LucaCorradi89/MotorPR_PCB/MotorPR.brd

## EAGLE design MotorPR.brd (2021-03-21)

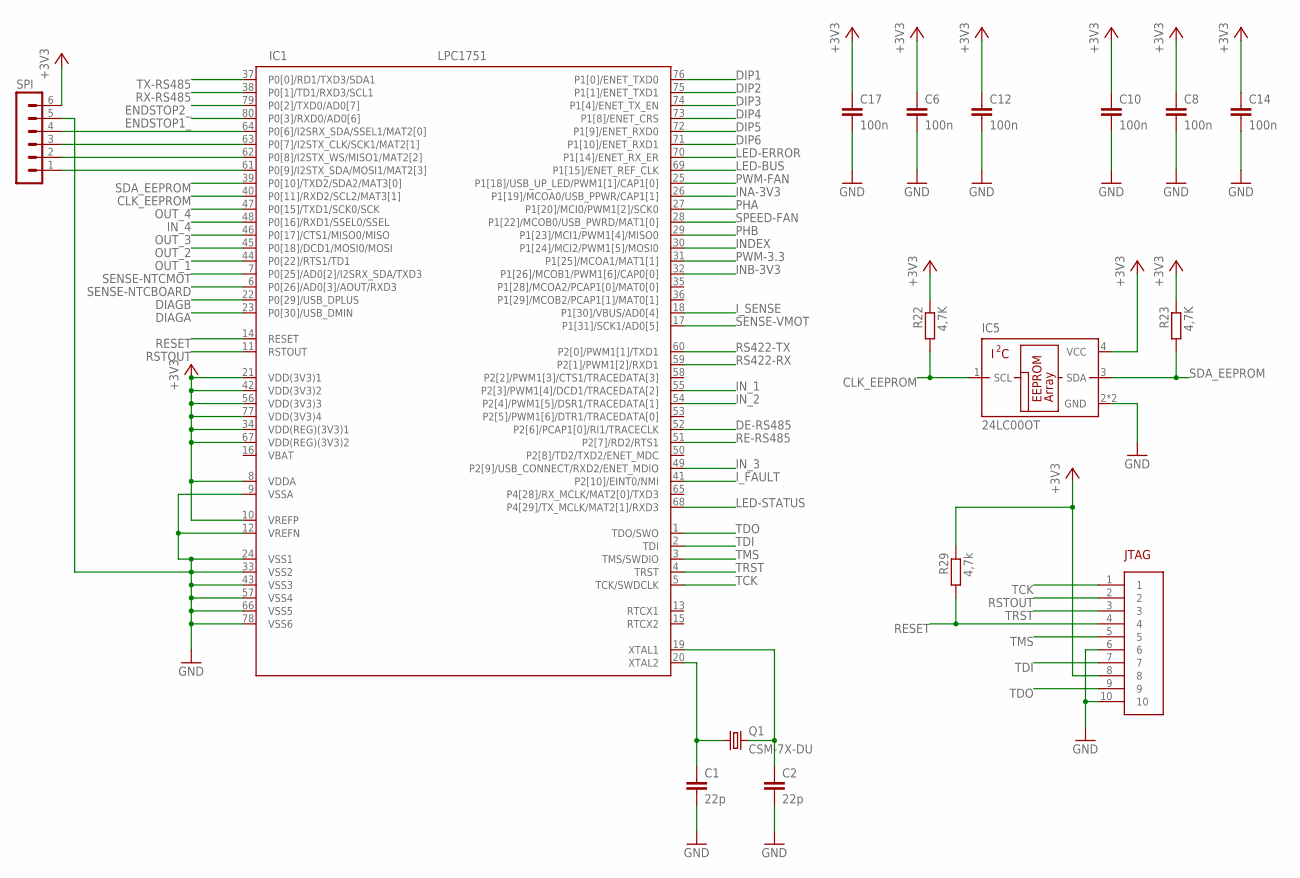
[picture p1: schematic MotorPR.sch, sheet 1, LOGICA]

Parts:
C1, C2: 22p; C0805
C6, C8, C10, C12, C14, C17: 100n; C0805
IC1: LPC1751; LQFP80-12X12
IC5: 24LC00OT; SOT23-5L
JTAG: MOLEX-52808-1070
Q1: CSM-7X-DU
R22, R23: 4,7K; R0805W
R29: 4,7k; R0805W
SPI: MA06-1

Connections:
+3V3: C6.1, C8.1, C10.1, C12.1, C14.1, C17.1, IC1.8 (VDDA), IC1.10 (VREFP), IC1.21 (VDD(3V3)1), IC1.34 (VDD(REG)(3V3)1), IC1.42 (VDD(3V3)2), IC1.56 (VDD(3V3)3), IC1.67 (VDD(REG)(3V3)2), IC1.77 (VDD(3V3)4), IC5.4 (VCC), JTAG.8, R22.1, R23.1, R29.1, SPI.6; also elsewhere on the board
CLK_EEPROM: IC1.40 (P0[11]/RXD2/SCL2/MAT3[1]), IC5.1 (SCL), R22.2
DE-RS485: IC1.52 (P2[6]/PCAP1[0]/RI1/TRACECLK); also elsewhere on the board
DIAGA: IC1.23 (P0[30]/USB_DMIN); also elsewhere on the board
DIAGB: IC1.22 (P0[29]/USB_DPLUS); also elsewhere on the board
DIP1: IC1.76 (P1[0]/ENET_TXD0); also elsewhere on the board
DIP2: IC1.75 (P1[1]/ENET_TXD1); also elsewhere on the board
DIP3: IC1.74 (P1[4]/ENET_TX_EN); also elsewhere on the board
DIP4: IC1.73 (P1[8]/ENET_CRS); also elsewhere on the board
DIP5: IC1.72 (P1[9]/ENET_RXD0); also elsewhere on the board
DIP6: IC1.71 (P1[10]/ENET_RXD1); also elsewhere on the board
ENDSTOP1_: IC1.80 (P0[3]/RXD0/AD0[6]); also elsewhere on the board
ENDSTOP2_: IC1.79 (P0[2]/TXD0/AD0[7]); also elsewhere on the board
GND: C1.2, C2.2, C6.2, C8.2, C10.2, C12.2, C14.2, C17.2, IC1.9 (VSSA), IC1.12 (VREFN), IC1.24 (VSS1), IC1.33 (VSS2), IC1.43 (VSS3), IC1.57 (VSS4), IC1.66 (VSS5), IC1.78 (VSS6), IC5.2 (GND), IC5.5 (GND), JTAG.6, JTAG.10, SPI.5; also elsewhere on the board
INA-3V3: IC1.26 (P1[19]/MCOA0/USB_PPWR/CAP1[1]); also elsewhere on the board
INB-3V3: IC1.32 (P1[26]/MCOB1/PWM1[6]/CAP0[0]); also elsewhere on the board
INDEX: IC1.30 (P1[24]/MCI2/PWM1[5]/MOSI0); also elsewhere on the board
IN_1: IC1.55 (P2[3]/PWM1[4]/DCD1/TRACEDATA[2]); also elsewhere on the board
IN_2: IC1.54 (P2[4]/PWM1[5]/DSR1/TRACEDATA[1]); also elsewhere on the board
IN_3: IC1.49 (P2[9]/USB_CONNECT/RXD2/ENET_MDIO); also elsewhere on the board
IN_4: IC1.48 (P0[16]/RXD1/SSEL0/SSEL); also elsewhere on the board
I_FAULT: IC1.41 (P2[10]/EINT0/NMI); also elsewhere on the board
I_SENSE: IC1.18 (P1[30]/VBUS/AD0[4]); also elsewhere on the board
LED-BUS: IC1.69 (P1[15]/ENET_REF_CLK); also elsewhere on the board
LED-ERROR: IC1.70 (P1[14]/ENET_RX_ER); also elsewhere on the board
LED-STATUS: IC1.68 (P4[29]/TX_MCLK/MAT2[1]/RXD3); also elsewhere on the board
unnamed: C2.1, IC1.19 (XTAL1), Q1.2
unnamed: IC1.61 (P0[9]/I2STX_SDA/MOSI1/MAT2[3]), SPI.1
unnamed: C1.1, IC1.20 (XTAL2), Q1.1
unnamed: IC1.62 (P0[8]/I2STX_WS/MISO1/MAT2[2]), SPI.2
unnamed: IC1.63 (P0[7]/I2STX_CLK/SCK1/MAT2[1]), SPI.3
unnamed: IC1.64 (P0[6]/I2SRX_SDA/SSEL1/MAT2[0]), SPI.4
OUT_1: IC1.44 (P0[22]/RTS1/TD1); also elsewhere on the board
OUT_2: IC1.45 (P0[18]/DCD1/MOSI0/MOSI); also elsewhere on the board
OUT_3: IC1.46 (P0[17]/CTS1/MISO0/MISO); also elsewhere on the board
OUT_4: IC1.47 (P0[15]/TXD1/SCK0/SCK); also elsewhere on the board
PHA: IC1.27 (P1[20]/MCI0/PWM1[2]/SCK0); also elsewhere on the board
PHB: IC1.29 (P1[23]/MCI1/PWM1[4]/MISO0); also elsewhere on the board
PWM-3.3: IC1.31 (P1[25]/MCOA1/MAT1[1]); also elsewhere on the board
PWM-FAN: IC1.25 (P1[18]/USB_UP_LED/PWM1[1]/CAP1[0]); also elsewhere on the board
RE-RS485: IC1.51 (P2[7]/RD2/RTS1); also elsewhere on the board
RESET: IC1.14 (RESET), JTAG.4, R29.2
RS422-RX: IC1.59 (P2[1]/PWM1[2]/RXD1); also elsewhere on the board
RS422-TX: IC1.60 (P2[0]/PWM1[1]/TXD1); also elsewhere on the board
RSTOUT: IC1.11 (RSTOUT), JTAG.2
RX-RS485: IC1.38 (P0[1]/TD1/RXD3/SCL1); also elsewhere on the board
SDA_EEPROM: IC1.39 (P0[10]/TXD2/SDA2/MAT3[0]), IC5.3 (SDA), R23.2
SENSE-NTCBOARD: IC1.6 (P0[26]/AD0[3]/AOUT/RXD3); also elsewhere on the board
SENSE-NTCMOT: IC1.7 (P0[25]/AD0[2]/I2SRX_SDA/TXD3); also elsewhere on the board
SENSE-VMOT: IC1.17 (P1[31]/SCK1/AD0[5]); also elsewhere on the board
SPEED-FAN: IC1.28 (P1[22]/MCOB0/USB_PWRD/MAT1[0]); also elsewhere on the board
TCK: IC1.5 (TCK/SWDCLK), JTAG.1
TDI: IC1.2 (TDI), JTAG.7
TDO: IC1.1 (TDO/SWO), JTAG.9
TMS: IC1.3 (TMS/SWDIO), JTAG.5
TRST: IC1.4 (TRST), JTAG.3
TX-RS485: IC1.37 (P0[0]/RD1/TXD3/SDA1); also elsewhere on the board
VBAT: IC1.16 (VBAT)

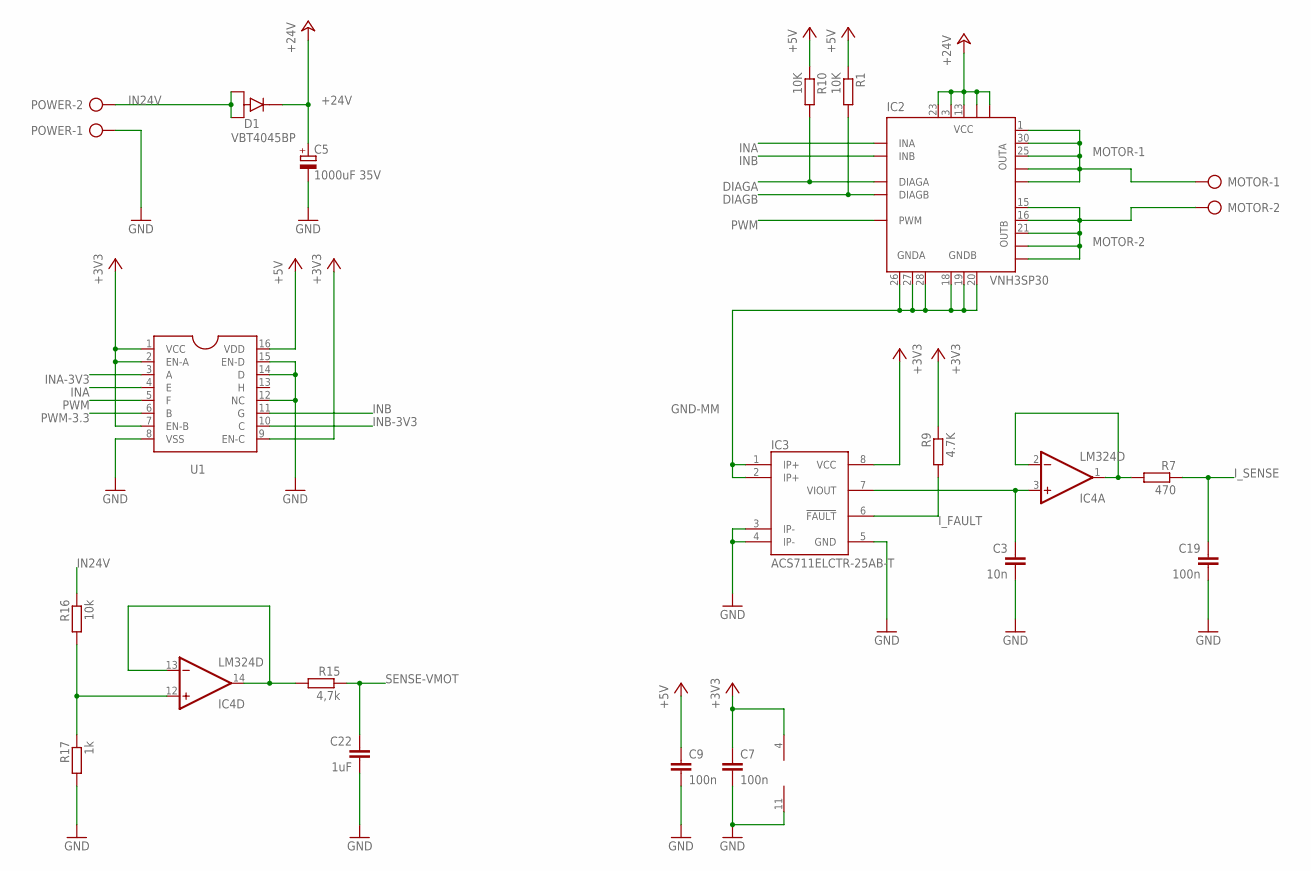
[picture p2: schematic MotorPR.sch, sheet 2, POTENZA]

Parts:
C3: 10n; C0805
C5: 1000uF 35V; E7,5-18
C7, C9, C19: 100n; C0805
C22: 1uF; C0805
D1: VBT4045BP; TO-263AB
IC2: VNH3SP30; MULTIPOWERSO-30
IC3: ACS711ELCTR-25AB-T; SO08
IC4: LM324D; SO14
MOTOR: AK300/2
POWER: AK300/2
R1, R10: 10K; R0805W
R7: 470; R0805W
R9: 4.7K; R0805W
R15: 4,7k; R0805W
R16: 10k; M1206
R17: 1k; M1206
U1: CD40109B; PW-PDSO-G16

Connections:
+3V3: C7.1, IC3.8 (VCC), IC4.4 (V+), R9.1, U1.1 (VCC), U1.2 (EN-A), U1.7 (EN-B), U1.9 (EN-C); also elsewhere on the board
+5V: C9.1, R1.1, R10.1, U1.16 (VDD); also elsewhere on the board
+24V: C5.+, D1.K, IC2.3 (VCC), IC2.13 (VCC), IC2.23 (VCC), IC2.VCC, IC2.VCC@1 (VCC)
DIAGA: IC2.6 (DIAGA), R10.2; also elsewhere on the board
DIAGB: IC2.10 (DIAGB), R1.2; also elsewhere on the board
GND: C3.2, C5.-, C7.2, C9.2, C19.2, C22.2, IC3.3 (IP-), IC3.4 (IP-), IC3.5 (GND), IC4.11 (V-), POWER.1, R17.2, U1.8 (VSS), U1.12 (NC), U1.14 (D), U1.15 (EN-D); also elsewhere on the board
GND-MM: IC2.18 (GNDB), IC2.19 (GNDB), IC2.20 (GNDB), IC2.26 (GNDA), IC2.27 (GNDA), IC2.28 (GNDA), IC3.1 (IP+), IC3.2 (IP+)
IN24V: D1.A1, D1.A2, POWER.2, R16.1; also elsewhere on the board
INA: IC2.5 (INA), U1.4 (E)
INA-3V3: U1.3 (A); also elsewhere on the board
INB: IC2.11 (INB), U1.11 (G)
INB-3V3: U1.10 (C); also elsewhere on the board
I_FAULT: IC3.6 (!FAULT!), R9.2; also elsewhere on the board
I_SENSE: C19.1, R7.1; also elsewhere on the board
MOTOR-1: IC2.1 (OUTA), IC2.25 (OUTA), IC2.30 (OUTA), IC2.OUTA, IC2.OUTA@1 (OUTA), MOTOR.1
MOTOR-2: IC2.15 (OUTB), IC2.16 (OUTB), IC2.21 (OUTB), IC2.OUTB, IC2.OUTB@1 (OUTB), MOTOR.2
unnamed: C3.1, IC3.7 (VIOUT), IC4.3 (+IN)
unnamed: IC4.13 (-IN), IC4.14 (OUT), R15.2
unnamed: IC4.1 (OUT), IC4.2 (-IN), R7.2
unnamed: IC4.12 (+IN), R16.2, R17.1
PWM: IC2.8 (PWM), U1.5 (F)
PWM-3.3: U1.6 (B); also elsewhere on the board
SENSE-VMOT: C22.1, R15.1; also elsewhere on the board

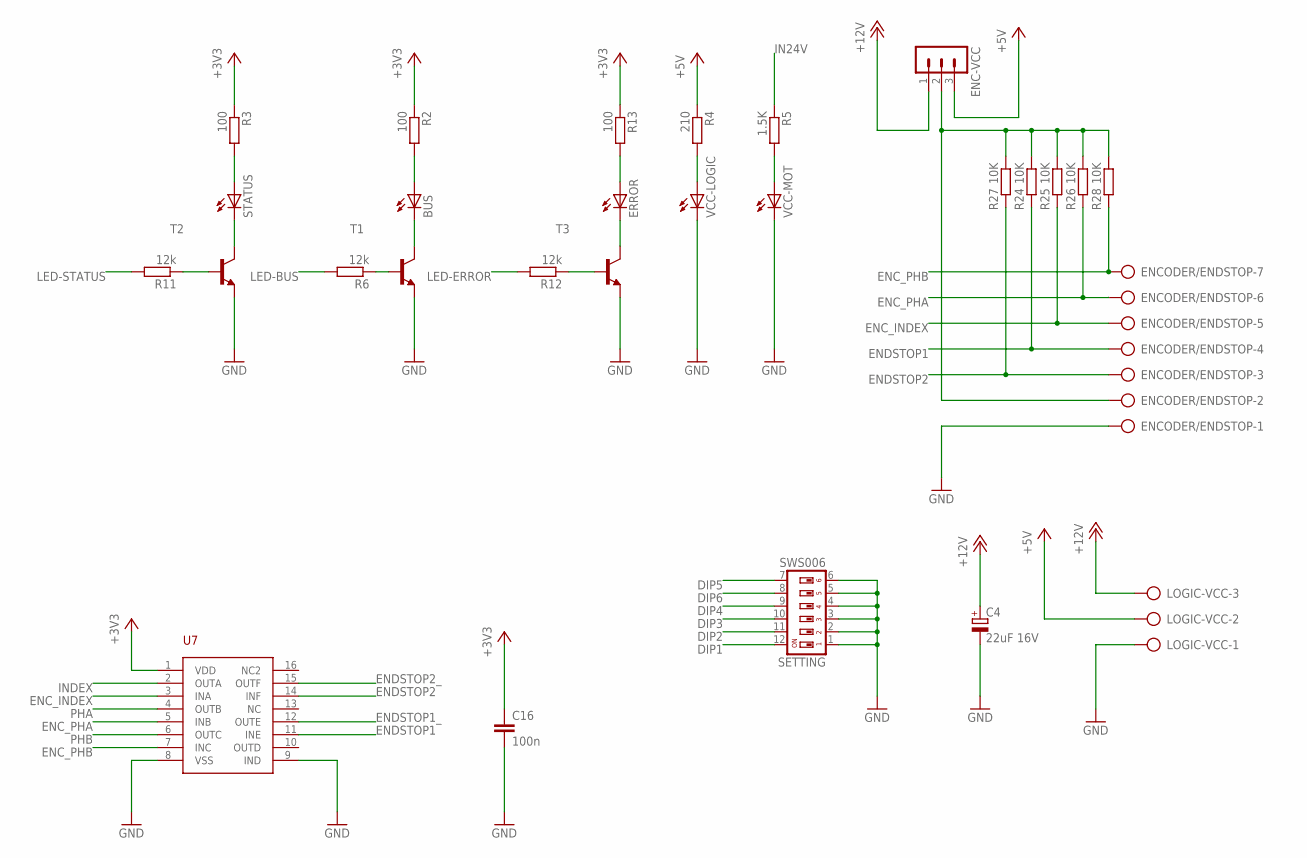
[picture p3: schematic MotorPR.sch, sheet 3, INTERFACCIA E AUSILIARI 1/2]

Parts:
BUS: LEDCHIPLED_1206; CHIPLED_1206
C4: 22uF 16V; 153CLV-0605
C16: 100n; C0805
ENC-VCC: MA03-1
ENCODER/ENDSTOP: AK300/7
ERROR: LEDCHIPLED_1206; CHIPLED_1206
LOGIC-VCC: AK300/3
R2, R3, R13: 100; R0805W
R4: 210; R0805W
R5: 1.5K; R0805W
R6, R11, R12: 12k; R0805W
R24, R25, R26, R27, R28: 10K; R0805W
SETTING: SWS006; DIP6-SMD
STATUS: LEDCHIPLED_1206; CHIPLED_1206
T1, T2, T3: BC808-NPN-SOT23-BEC; SOT23-BEC
U7: MC14050B; PDSO-G16
VCC-LOGIC: LEDCHIPLED_1206; CHIPLED_1206
VCC-MOT: LEDCHIPLED_1206; CHIPLED_1206

Connections:
+3V3: C16.1, R2.1, R3.1, R13.1, U7.1 (VDD); also elsewhere on the board
+5V: ENC-VCC.3, LOGIC-VCC.2, R4.1; also elsewhere on the board
+12V: C4.+, ENC-VCC.1, LOGIC-VCC.3; also elsewhere on the board
DIP1: SETTING.12; also elsewhere on the board
DIP2: SETTING.11; also elsewhere on the board
DIP3: SETTING.10; also elsewhere on the board
DIP4: SETTING.9; also elsewhere on the board
DIP5: SETTING.7; also elsewhere on the board
DIP6: SETTING.8; also elsewhere on the board
ENC_INDEX: ENCODER/ENDSTOP.5, R25.2, U7.3 (INA)
ENC_PHA: ENCODER/ENDSTOP.6, R26.2, U7.5 (INB)
ENC_PHB: ENCODER/ENDSTOP.7, R28.2, U7.7 (INC)
ENDSTOP1: ENCODER/ENDSTOP.4, R24.2, U7.11 (INE)
ENDSTOP1_: U7.12 (OUTE); also elsewhere on the board
ENDSTOP2: ENCODER/ENDSTOP.3, R27.2, U7.14 (INF)
ENDSTOP2_: U7.15 (OUTF); also elsewhere on the board
GND: C4.-, C16.2, ENCODER/ENDSTOP.1, LOGIC-VCC.1, SETTING.1, SETTING.2, SETTING.3, SETTING.4, SETTING.5, SETTING.6, T1.E, T2.E, T3.E, U7.8 (VSS), U7.9 (IND), VCC-LOGIC.C, VCC-MOT.C; also elsewhere on the board
IN24V: R5.1; also elsewhere on the board
INDEX: U7.2 (OUTA); also elsewhere on the board
LED-BUS: R6.2; also elsewhere on the board
LED-ERROR: R12.2; also elsewhere on the board
LED-STATUS: R11.2; also elsewhere on the board
unnamed: R6.1, T1.B
unnamed: R11.1, T2.B
unnamed: R12.1, T3.B
unnamed: R5.2, VCC-MOT.A
unnamed: R4.2, VCC-LOGIC.A
unnamed: BUS.C, T1.C
unnamed: BUS.A, R2.2
unnamed: ERROR.A, R13.2
unnamed: ERROR.C, T3.C
unnamed: STATUS.C, T2.C
unnamed: R3.2, STATUS.A
unnamed: ENC-VCC.2, ENCODER/ENDSTOP.2, R24.1, R25.1, R26.1, R27.1, R28.1
PHA: U7.4 (OUTB); also elsewhere on the board
PHB: U7.6 (OUTC); also elsewhere on the board

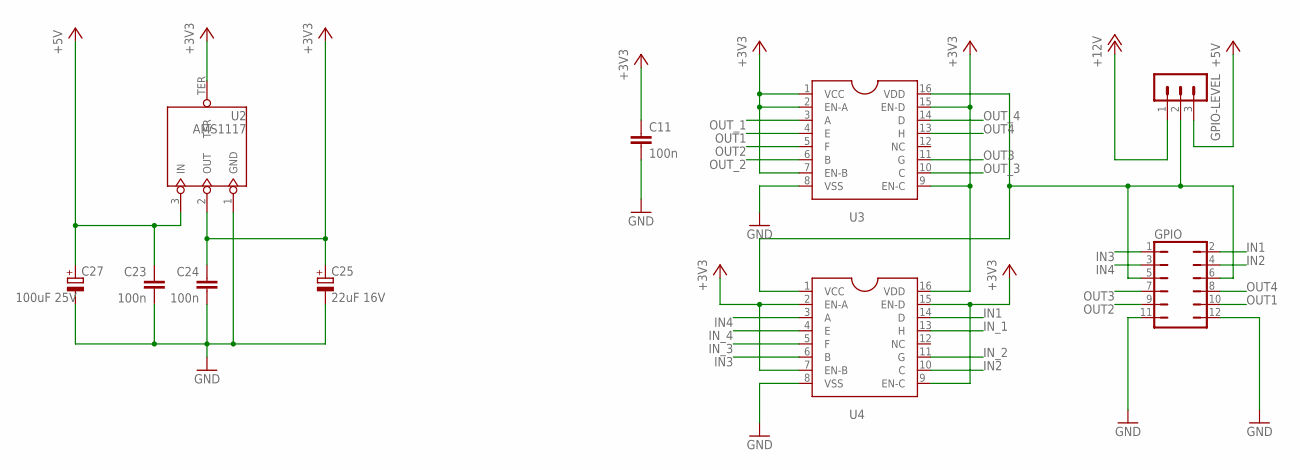
[picture p4: schematic MotorPR.sch, sheet 4, INTERFACCIA E AUSILIARI 2/2]

Parts:
C11, C23, C24: 100n; C0805
C25: 22uF 16V; 153CLV-0605
C27: 100uF 25V; 153CLV-0807
GPIO: JP6Q
GPIO-LEVEL: MA03-1
U2: AMS1117; SOT-223
U3, U4: CD40109B; PW-PDSO-G16

Connections:
+3V3: C11.1, C24.1, C25.+, U2.2 (OUT), U2.TER, U3.1 (VCC), U3.2 (EN-A), U3.7 (EN-B), U3.9 (EN-C), U3.15 (EN-D), U4.2 (EN-A), U4.7 (EN-B), U4.9 (EN-C), U4.15 (EN-D), U4.16 (VDD); also elsewhere on the board
+5V: C23.1, C27.+, GPIO-LEVEL.3, U2.3 (IN); also elsewhere on the board
+12V: GPIO-LEVEL.1; also elsewhere on the board
GND: C11.2, C23.2, C24.2, C25.-, C27.-, GPIO.11, GPIO.12, U2.1 (GND), U3.8 (VSS), U4.8 (VSS); also elsewhere on the board
IN1: GPIO.2, U4.14 (D)
IN2: GPIO.4, U4.10 (C)
IN3: GPIO.1, U4.6 (B)
IN4: GPIO.3, U4.3 (A)
IN_1: U4.13 (H); also elsewhere on the board
IN_2: U4.11 (G); also elsewhere on the board
IN_3: U4.5 (F); also elsewhere on the board
IN_4: U4.4 (E); also elsewhere on the board
unnamed: GPIO.5, GPIO.6, GPIO-LEVEL.2, U3.16 (VDD), U4.1 (VCC)
OUT1: GPIO.10, U3.4 (E)
OUT2: GPIO.9, U3.5 (F)
OUT3: GPIO.7, U3.11 (G)
OUT4: GPIO.8, U3.13 (H)
OUT_1: U3.3 (A); also elsewhere on the board
OUT_2: U3.6 (B); also elsewhere on the board
OUT_3: U3.10 (C); also elsewhere on the board
OUT_4: U3.14 (D); also elsewhere on the board

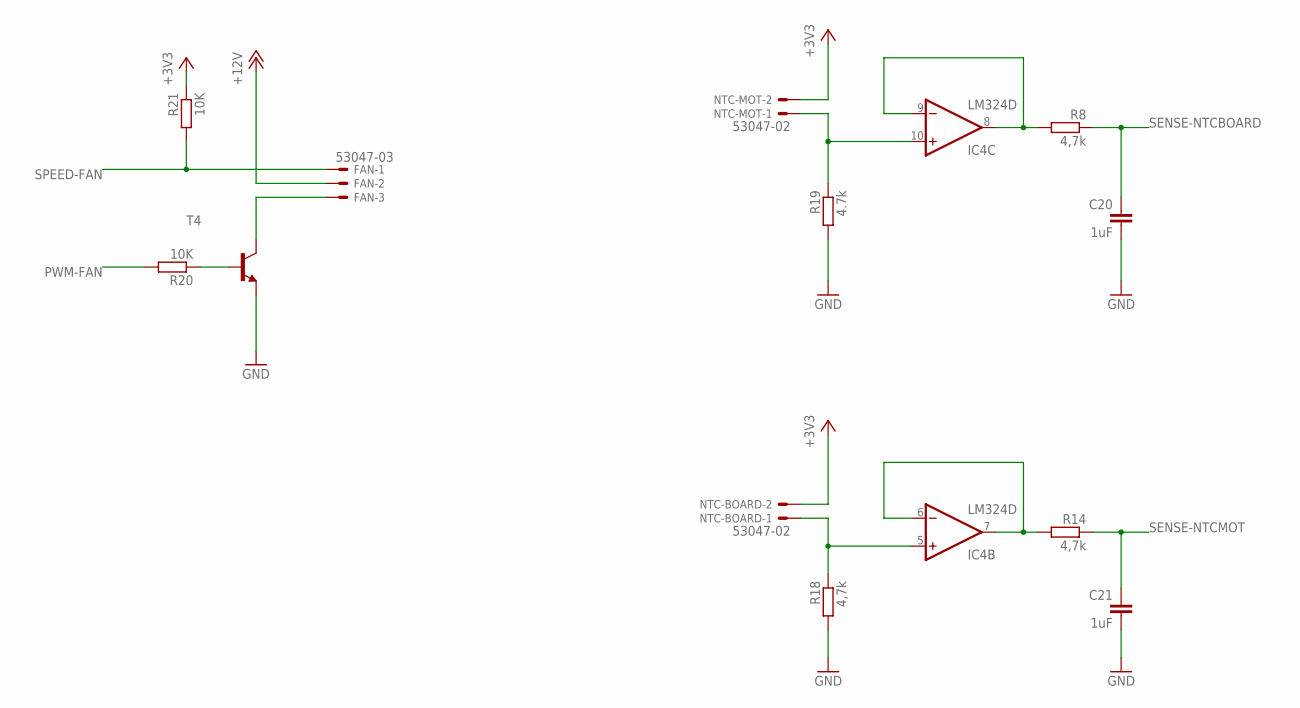
[picture p5: schematic MotorPR.sch, sheet 5, GESTIONE TEMPERATURA]

Parts:
C20, C21: 1uF; C0805
FAN: 53047-03
IC4: LM324D; SO14
NTC-BOARD: 53047-02
NTC-MOT: 53047-02; MPN 53047-0210
R8, R14: 4,7k; R0805W
R18: 4,7k; M1206
R19: 4.7k; M1206
R20, R21: 10K; R0805W
T4: BC808-NPN-SOT23-BEC; SOT23-BEC

Connections:
+3V3: NTC-BOARD.2, NTC-MOT.2, R21.1; also elsewhere on the board
+12V: FAN.2; also elsewhere on the board
GND: C20.2, C21.2, R18.2, R19.2, T4.E; also elsewhere on the board
unnamed: IC4.8 (OUT), IC4.9 (-IN), R8.2
unnamed: IC4.6 (-IN), IC4.7 (OUT), R14.2
unnamed: IC4.5 (+IN), NTC-BOARD.1, R18.1
unnamed: IC4.10 (+IN), NTC-MOT.1, R19.1
unnamed: R20.1, T4.B
unnamed: FAN.3, T4.C
PWM-FAN: R20.2; also elsewhere on the board
SENSE-NTCBOARD: C20.1, R8.1; also elsewhere on the board
SENSE-NTCMOT: C21.1, R14.1; also elsewhere on the board
SPEED-FAN: FAN.1, R21.2; also elsewhere on the board

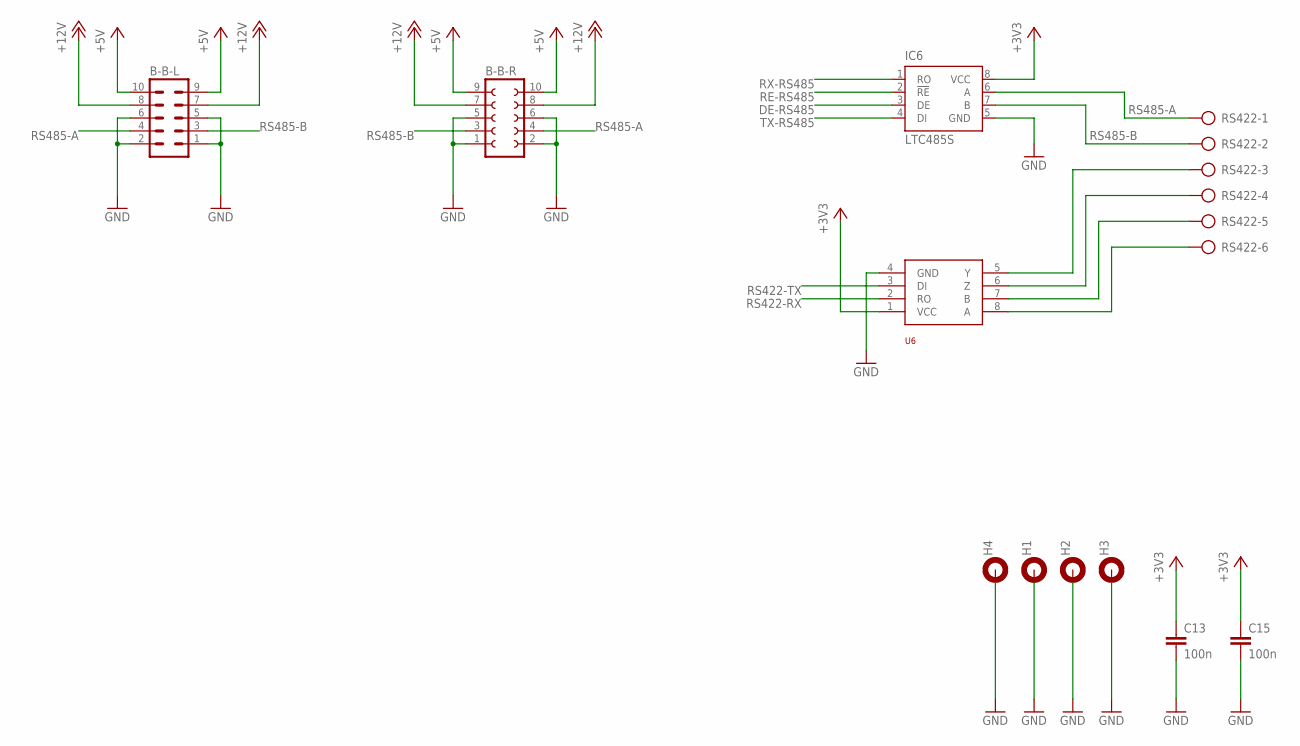
[picture p6: schematic MotorPR.sch, sheet 6, COMUNICAZIONE]

Parts:
B-B-L: MA05-2
B-B-R: FE05-2W
C13, C15: 100n; C0805
H1, H2, H3, H4: MOUNT-PAD-ROUND3.0; 3,0-PAD
IC6: LTC485S; SOIC8
RS422: AK300/6
U6: ISL83490IBZ; R-PDSO-G8

Connections:
+3V3: C13.1, C15.1, IC6.8 (VCC), U6.1 (VCC); also elsewhere on the board
+5V: B-B-L.9, B-B-L.10, B-B-R.9, B-B-R.10; also elsewhere on the board
+12V: B-B-L.7, B-B-L.8, B-B-R.7, B-B-R.8; also elsewhere on the board
DE-RS485: IC6.3 (DE); also elsewhere on the board
GND: B-B-L.1, B-B-L.2, B-B-L.5, B-B-L.6, B-B-R.1, B-B-R.2, B-B-R.5, B-B-R.6, C13.2, C15.2, H1.B3,0, H2.B3,0, H3.B3,0, H4.B3,0, IC6.5 (GND), U6.4 (GND); also elsewhere on the board
unnamed: RS422.3, U6.5 (Y)
unnamed: RS422.4, U6.6 (Z)
unnamed: RS422.5, U6.7 (B)
unnamed: RS422.6, U6.8 (A)
RE-RS485: IC6.2 (!RE); also elsewhere on the board
RS422-RX: U6.2 (RO); also elsewhere on the board
RS422-TX: U6.3 (DI); also elsewhere on the board
RS485-A: B-B-L.4, B-B-R.4, IC6.6 (A), RS422.1
RS485-B: B-B-L.3, B-B-R.3, IC6.7 (B), RS422.2
RX-RS485: IC6.1 (RO); also elsewhere on the board
TX-RS485: IC6.4 (DI); also elsewhere on the board

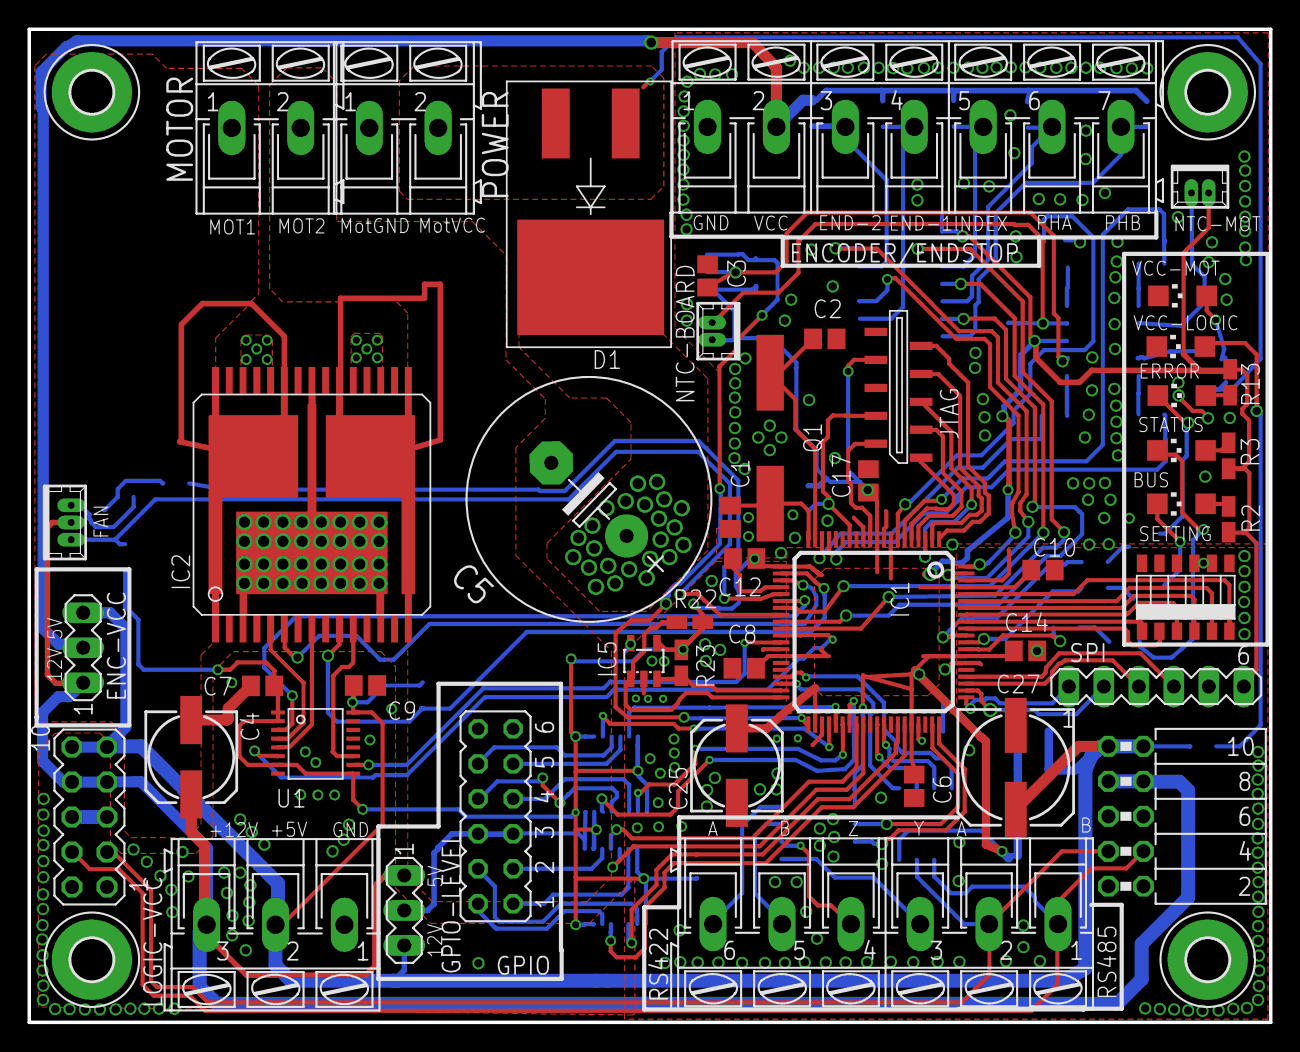
[picture p7: board MotorPR.brd from above]

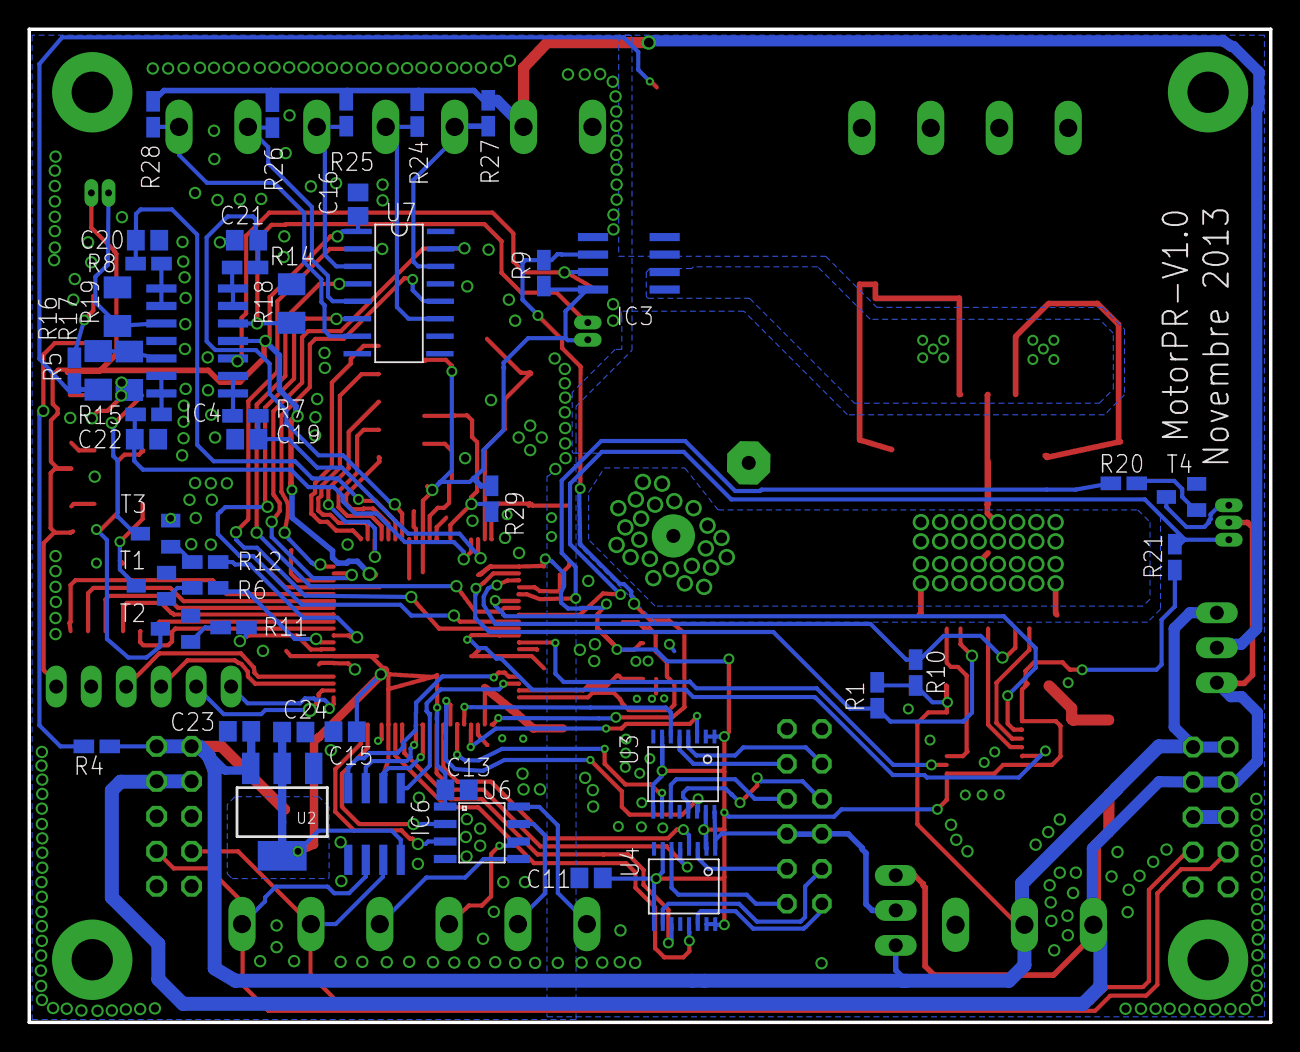
[picture p8: board MotorPR.brd from below]

Board: 2 copper layers, 90.1 x 72.1 mm, 97 parts (46 on the bottom side), 109 nets.
